Kreyl/SimpleJoy/ТЗ LiveTronic SimpleJoy v2.0 от 21.09.2017.pdf

# Техническое задание на разработку LiveTronic SimpleJoy

## Реализация управления устройствами детям 1-4 класса

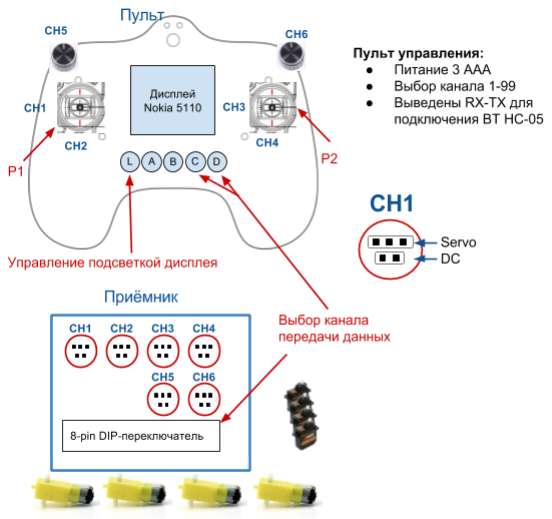
[picture p1: figure]

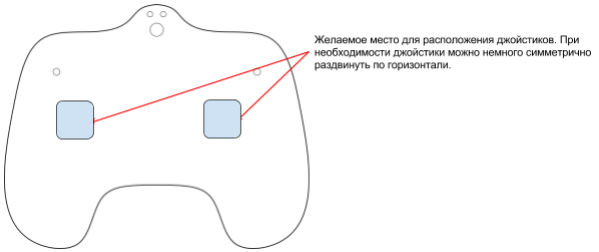
[picture p2: figure]

Пульт | управления
- Пульт | имеет | 6 | дифференциальных | каналов | для | управления: | CH1-CH6
CH1-CH4 работают в двух режимах: могут управлять DC-мотором либо сервомотором, сигнал подаётся одновременно, поэтому действовать будут синхронно. Сигнал от CH1-CH4 - градуальный.
- CH5-CH6 могут управлять сервомоторами либо двумя коллекторными моторами через полевой транзистор.
- Джойстики P1 И P2 также имеют кнопку на нажатие. Их необходимо завести на МК.
- Автокалибровка пульта: при включении пульт автоматически считает, что показания на реостатах являются нулевыми.
- Питание: 3ААA
- Радиус действия - не менее 50 метров уверенный приём сигнала (в идеале до 100)
- Если есть возможность, оставить место для последующей пайки модуля BT HC-05, если такой возможности нет, то оставить выводы RX и TX для подключения модуля без пайки.
- С МК необходимо управлять подсветкой дисплея
- Под дисплеем расположены 5 тактовых кнопок. Две из них в базовой прошивке используются для переключения каналов. Одна — подсветкой дисплея.
- По периметру платы требуются 4 крепёжные отверстия 3мм
- Разъём micro-USB для программирования MK и передачи команд с ПК
- Необходим главный переключатель/кнопка

## Приёмник

- Приёмник | имеет | 6 | дифференциальных | каналов: | CH1-CH6
CH1-CH4 работают в двух режимах: могут управлять DC-мотором либо сервомотором, сигнал подаётся одновременно, поэтому действовать будут синхронно. Сигнал от CH1-CH4 - градуальный.
- Питание
- Стабилизированные 5V
- 6V — 4AA батарейки
- 4.8V — 4AA аккумулятора

Разъём питания
http://www.zip-2002.ru/razyemy/razyemy_pitaniya_nizkovoltnye/55052/w-02_pitch_2.54mm/http://www.zip-2002.ru/razyemy/razyemy_pitaniya_nizkovoltnye/55070/w-02r_pitch_2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Предполагаемые компоненты:
Джойстик (https://ru.aliexpress.com/item/2pcs-3D-Controller-Joystick-Axis-Analog-Sensor-Modules-Thumbsticks-3D-Joystick-Handle-Rocker-For-Xbox-One/32720014359.html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)

Тактовые кнопки (http://www.zip-2002.ru/kommutatsiya/taktovye_knopki/83335/it-1187a_(4x4x4.3)/)

Референсы | на | дизайн
BT Джойстик (https://ru.aliexpress.com/item/ipega-pg-9055-Wireless-Bluetooth-Game-Controller-Joystick-For-iPhone-iPad-Android-Mobile-Phones-Tablet-PC/32791721858.html)

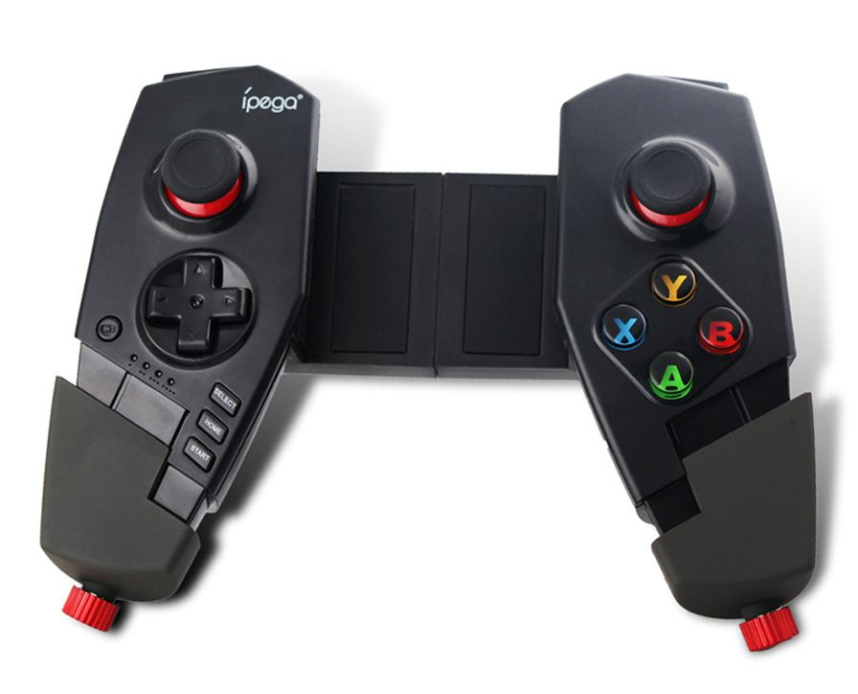
[picture p3: figure]
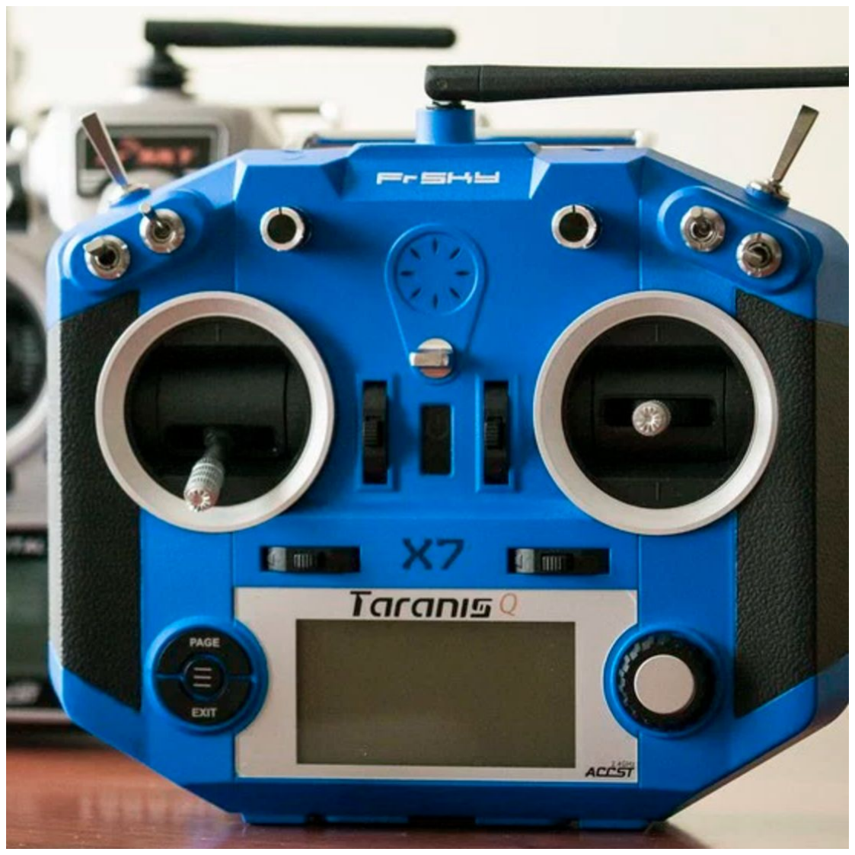
[picture p4: figure]
