Kreyl/SimpleJoy/SimpleJoyCommonBOM.xlsx

Reference | Value | Footprint | Quantity | SolderPoints | Price | Sum | PN | URL | Color
B1 | BAT | Installation:BATTERY_AAA_X3 | 1 | 2 | 30 | 30 |  | http://www.quartz1.com/price/model.php?akt=5470.11
BLN1 | BALUN868JOHANSON | Radio:BALUN_JOHANSON868 | 1 | 6 | 45 | 45 | 0896BM15A0001E | http://onelec.ru/products/0896bm15a0001e-52ab3408-7c12-4b8c-99ab-cc294cdc1e18
C1 C10 | 10n | Capacitors:CAP_0603 | 2 | 2 | 0.5 | 1
C11 C17 | 1u | Capacitors:CAP_0603 | 2 | 2 | 0.5 | 1
C14 C15 C3 C4 | 18pF | Capacitors:CAP_0603 | 4 | 2 | 0.5 | 2
C12 C13 C16 C18 C19 C21 C22 C24 C25 C5 C6 C7 C8 C9 | 0.1u | Capacitors:CAP_0603 | 14 | 2 | 0.5 | 7
C2 | 10u | Capacitors:CAP_0603 | 1 | 2 | 4 | 4
C20 | 2pF | Capacitors:CAP_0402 | 1 | 2 | 0.5 | 0.5
D1 D5 | L-C191LBCT | LEDs:LED_0603 | 2 | 2 | 2.4 | 4.8 | L-C191LBCT | http://onelec.ru/products/l-c191lbct | Blue
D2 D3 | PMEG2020 | Diodes:SOD323 | 2 | 2 | 5 | 10
D4 | L-C191KGCT | LEDs:LED_0603 | 1 | 2 | 2.2 | 2.2 | L-C191KGCT | http://onelec.ru/products/l-c191kgct | Green
DA1 | MCP1700 | SOT:SOT23-3 | 1 | 3 | 20 | 20 | MCP1700T-3302E/TT
DD1 | STM32F072RxTx | LQFP_TQFP:LQFP64 | 1 | 64 | 170 | 170 | stm32f072R8t6 | http://
DD2 | CC1101 | QFN_DFN:QFN20 | 1 | 21 | 140 | 140 |  | http://
J1 J2 | Joystick | BtnsSwitches:Joystick | 2 | 14 | 35 | 70 |  | https://ru.aliexpress.com/item/2pcs-3D-Controller-Joystick-Axis-Analog-Sensor-Modules-Thumbsticks-3D-Joystick-Handle-Rocker-For-Xbox-One/32720014359.html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
L1 L2 L3 | BLM15AG102 | Inductors:IND_0402 | 3 | 2 | 1 | 3 | BLM15AG102SN1
L4 | 1.2nH | Inductors:IND_0402 | 1 | 2 | 4 | 4
Q1 | 2N7002 | SOT:SOT23-3 | 1 | 3 | 1.6 | 1.6
R1 | 51R | Resistors:RES_0603 | 1 | 2 | 0.5 | 0.5
R12 R13 R2 R3 R5 | 1k | Resistors:RES_0603 | 5 | 2 | 0.5 | 2.5
R4 R9 | 56k | Resistors:RES_0603 | 2 | 2 | 0.5 | 1
R6 R7 | 10k | Resistors:VAR_PTV09A-4 | 2 | 5 | 11 | 22 |  | http://www.zip-2002.ru/rezistory/potentsiometry/69732/rs09-n-30_10k/
R10 R11 R8 | 100k | Resistors:RES_0603 | 3 | 2 | 0.5 | 1.5
SW2 | DIPx8 | BtnsSwitches:DIP_SMD_X8 | 1 | 16 | 35 | 35 | 1-1825058-9 | https://www.terraelectronica.ru/catalog_info.php?CODE=854801
SW3 | SWITCH | BtnsSwitches:SW_SS-12F23 | 1 | 5 | 5 | 5
SW1 SW4 SW5 SW6 SW7 SW8 | IT-1187A | BtnsSwitches:BTN_4x4_SMD | 6 | 4 | 4 | 24 |  | http://www.zip-2002.ru/kommutatsiya/taktovye_knopki/83335/it-1187a_(4x4x4.3)/
U1 | USBLC6 | SOT:SOT23-6 | 1 | 6 | 9 | 9 | USBLC6-2SC6 | https://www.terraelectronica.ru/catalog_info.php?CODE=244787
U2 | BT_HC05 | Modules:BT_HC0x | 1 | 34 |  | 0
XL1 | PBS-8 | Connectors:PLS-8 | 1 | 8 | 24 | 24 |  | http://www.quartz1.com/price/model.php?group=1136&ext=1932
XL2 | CONN_6 | Connectors:PLS-6 | 1 | 6 | 2 | 2
XL3 | USB_MINI_B | Connectors:USBmicro_MOLEX_WM17142 | 1 | 9 | 46 | 46 | 47491-0001
XL4 | CONN_1 | Connectors:PLS-1Rnd | 1 | 0 | 0 | 0
XTAL1 | 12MHz | Quartz:0503x4-4 | 1 | 4 | 15 | 15
XTAL2 | 27MHz | Quartz:03225C4 | 1 | 4 | 15 | 15
Печатная плата TX |  |  |  |  |  | 250
BLN1 | BALUN868JOHANSON | Radio:BALUN_JOHANSON868 | 1 | 6 | 45 | 0896BM15A0001E | http://onelec.ru/products/0896bm15a0001e-52ab3408-7c12-4b8c-99ab-cc294cdc1e18
C2 | 10u | Capacitors:CAP_0603 | 1 | 2 | 4
C26 C27 | 18pF | Capacitors:CAP_0603 | 2 | 2 | 0.5
C10 C11 C18 C19 C20 C21 C24 C25 C28 C3 C31 C33 C36 C37 C39 C4 C41 C42 C43 C5 C6 C7 | 0.1u | Capacitors:CAP_0603 | 22 | 2 | 0.5
C35 | 2.4pF | Capacitors:CAP_0402 | 1 | 2 | 0.5
C12 C13 C14 C15 C16 C17 C30 C38 | 100u 6V3 | Capacitors:CAP_1206 | 8 | 2 | 7 | CL31A107MQHNNNE
C1 C8 | 10n | Capacitors:CAP_0603 | 2 | 2 | 0.5
C32 C9 | 1u | Capacitors:CAP_0603 | 2 | 2 | 0.5
D1 | L-C191KGCT | LEDs:LED_0603 | 1 | 2 | 2.2 | L-C191KGCT | http://onelec.ru/products/l-c191kgct |  |  | Green
D2 | L-C191LBCT | LEDs:LED_0603 | 1 | 2 | 2.4 | L-C191LBCT | http://onelec.ru/products/l-c191lbct |  |  | Blue
D3 D4 D5 D6 | PMEG2020 | Diodes:SOD323 | 4 | 2 | 5.5 | PMEG2020EJ.115 | https://www.terraelectronica.ru/catalog_info.php?CODE=192057 | 2A 20V Vf=525mV
DA1 DA2 | DRV8835 | QFN_DFN:WSON12 | 2 | 13 | 95 | DRV8835DSSR | http://onelec.ru/products/drv8835dssr
DA3 DA7 | MCP1700 | SOT:SOT23-3A | 2 | 3 | 20 | MCP1700T-3302E/TT
DD1 | STM32F072RxTx | LQFP_TQFP:LQFP64 | 1 | 64 | 170 | stm32f072R8t6 | http://
DD2 | CC1101 | QFN_DFN:QFN20 | 1 | 21 | 140 |  | http://
L1 | BLM15AG102SN1 | Inductors:IND_0402 | 1 | 2 | 1
L2 | 1.2nH | Inductors:IND_0402 | 1 | 2 | 4
Q1 | IRF9358 | SO_DIL_TSSOP:SO8_150MIL | 1 | 8 | 29 |  | http://onelec.ru/products/irf9358pbf-dd012426-33d8-429e-9c6a-2b35b0a91da1
Q2 | 2N7002 | SOT:SOT23-3 | 1 | 3 | 1.6
Q3 Q4 | IRLML0030 | SOT:SOT23-3 | 2 | 3 | 7.5 | IRLML0030TRPBF | https://www.terraelectronica.ru/catalog.php?ID=349&search=irlml0030
R1 R3 R4 R5 | 1k | Resistors:RES_0603 | 4 | 2 | 0.5
R10 R6 R7 R9 | 100k | Resistors:RES_0603 | 4 | 2 | 0.5
R11 R12 R2 R8 | 56k | Resistors:RES_0603 | 4 | 2 | 0.5
SW1 | DIPx8 | BtnsSwitches:DIP_SMD_X8 | 1 | 16 | 27 |  | http://www.zip-2002.ru/kommutatsiya/dip_pereklyuchateli/71280/swd_4-8/
SW2 | IT-1187A | BtnsSwitches:BTN_4x4_SMD | 1 | 4 | 4 | IT-1187A
SW3 | 1P2T | BtnsSwitches:SW_SS-1P2T | 1 | 3 | 10
U1 | USBLC6 | SOT:SOT23-6 | 1 | 6 | 9 | USBLC6-2SC6 | https://www.terraelectronica.ru/catalog_info.php?CODE=244787
XL1 | CONN_6 | Connectors:PLS-6 | 1 | 6 | 1
XL10 XL11 XL12 XL13 XL15 XL16 XL19 XL20 XL21 XL9 | PLS3 | Connectors:PLS-3 | 10 | 3 | 1
XL14 XL17 XL4 XL5 XL6 XL7 XL8 | PLS2 | Connectors:PLS-2 | 7 | 2 | 0.5 |  |  |  | 2
XL18 | CONN_1 | Connectors:PLS-1Rnd | 1 | 0 | 0
XL2 | USB_MICRO | Connectors:USBmicro_MOLEX_1050170001 | 1 | 9 | 46 | 47491-0001
XL3 | CONN_2 | Connectors:W02_Pitch_2d54 | 1 | 2 | 2
XTAL1 | 27MHz | Quartz:03225C4 | 1 | 4 | 15
Печатная плата |  |  | 1 |  | 155 | 155
