Kreyl/SimpleJoy/Display.DXF

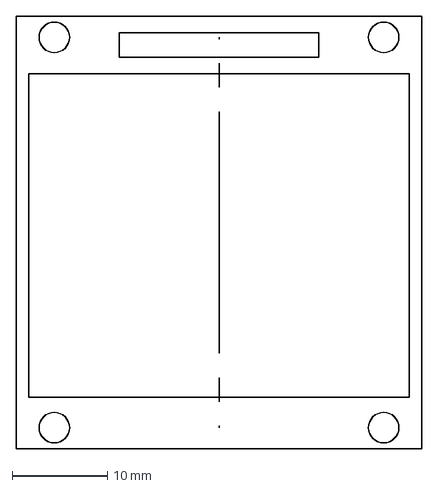
[picture p5: CAD file, 2022-06-04]
Display.DXF
42.6 x 45.4 mm
