Kreyl/SimpleJoy/Tx.dxf

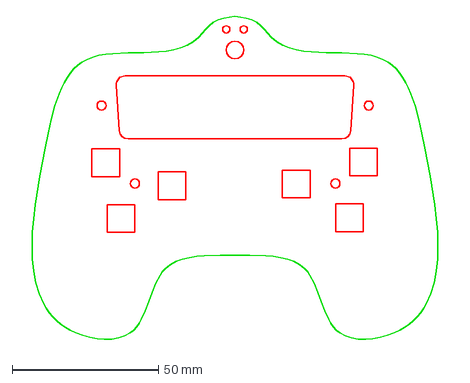
[picture p6: CAD file, 2022-06-04]
Tx.dxf
149.8 x 111.7 mm
