Kreyl/SimpleJoy/(list of files, cad)

Other CAD files:
TX.dwg
