Kreyl/SimpleJoy/SimpleJoyReceiverSch.pdf

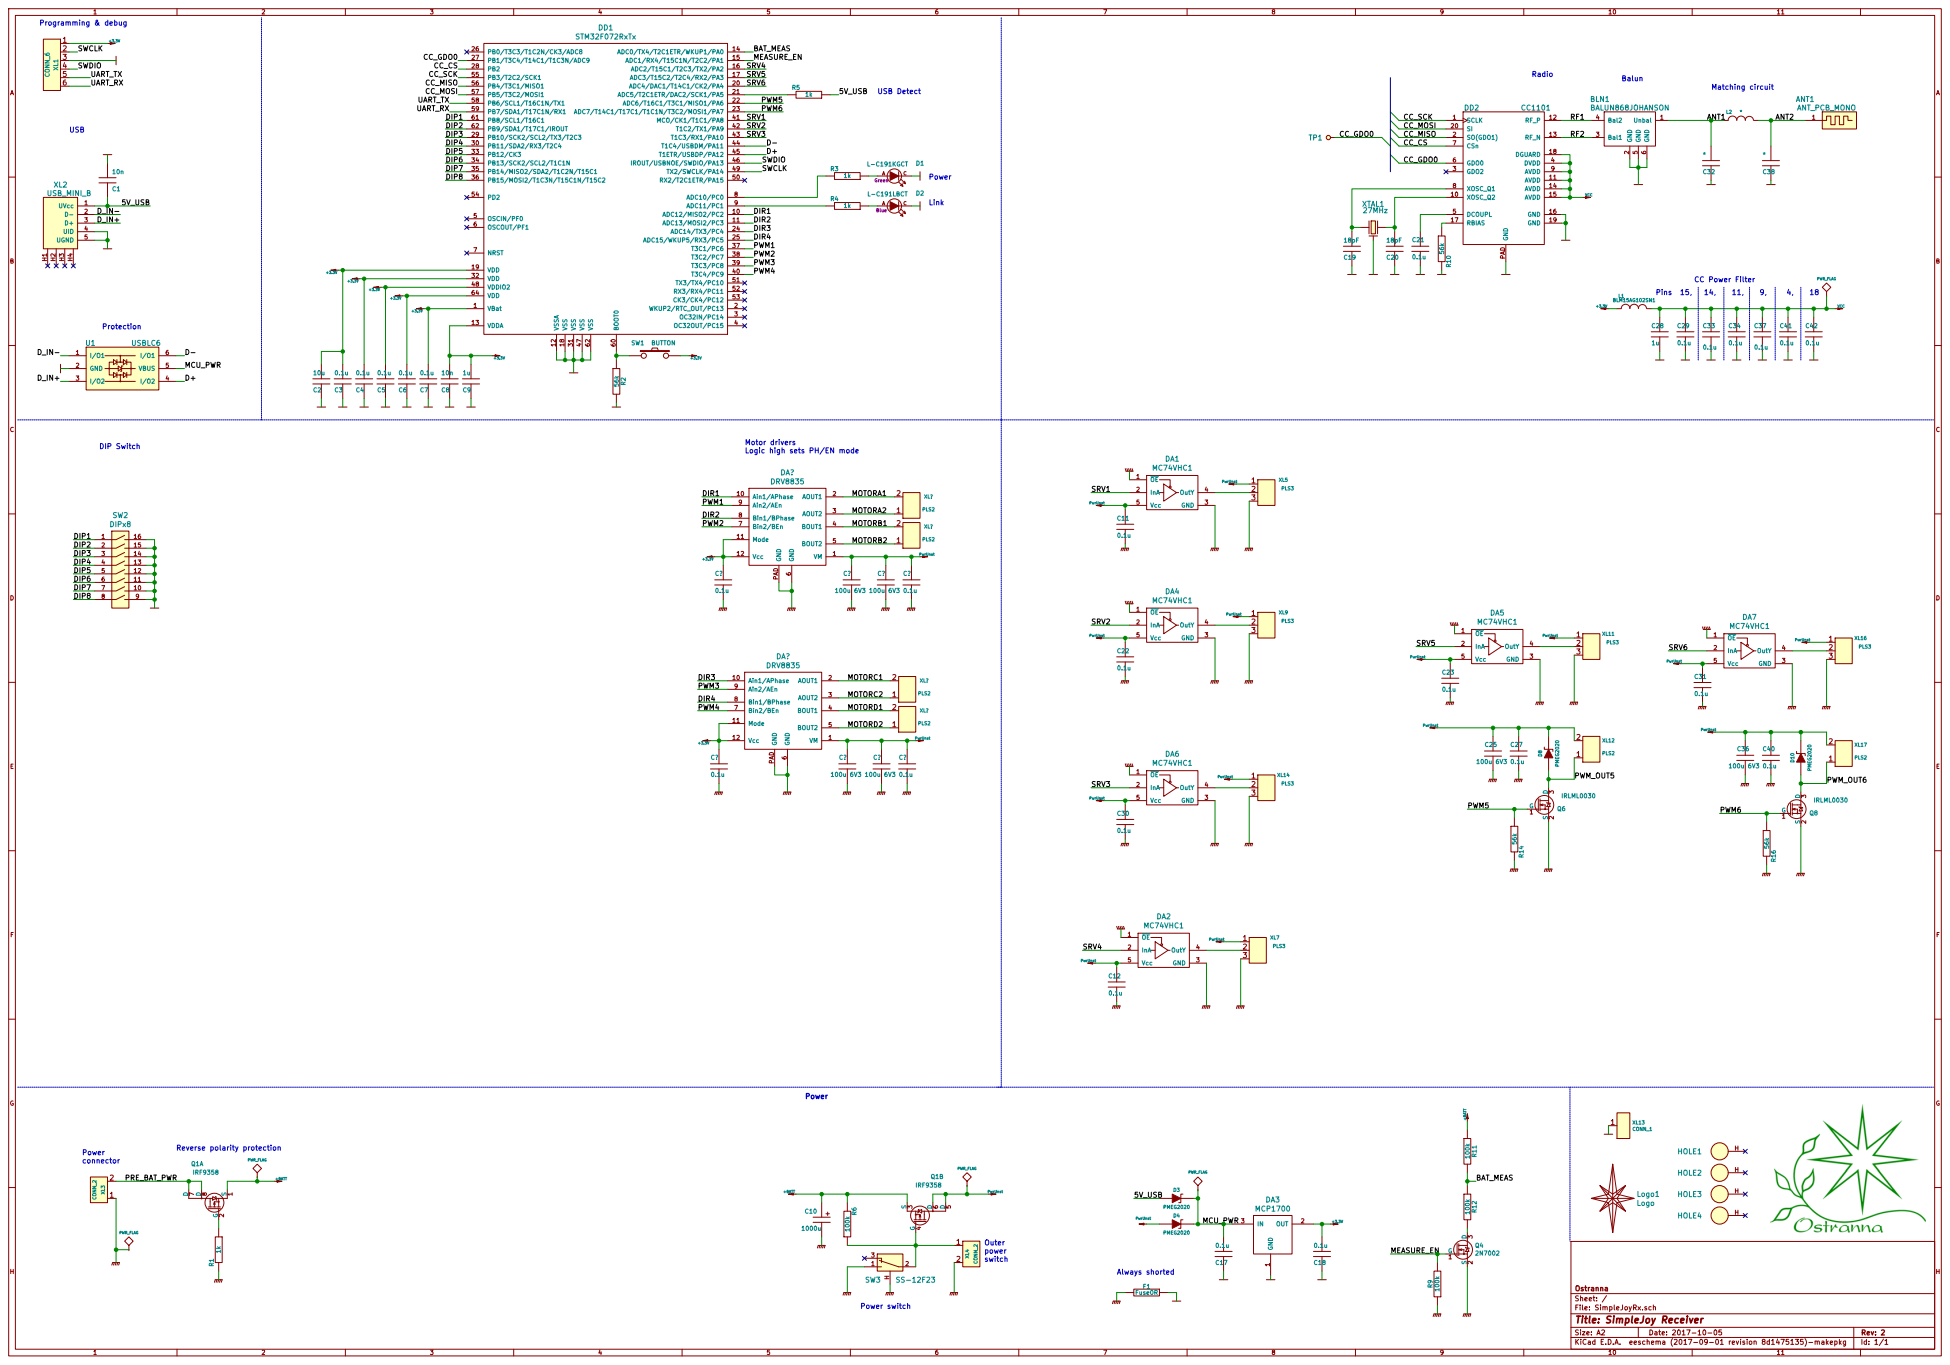
[picture p7: page 1]
