Kreyl/SimpleJoy/SimpleJoyTransmitterSch.pdf

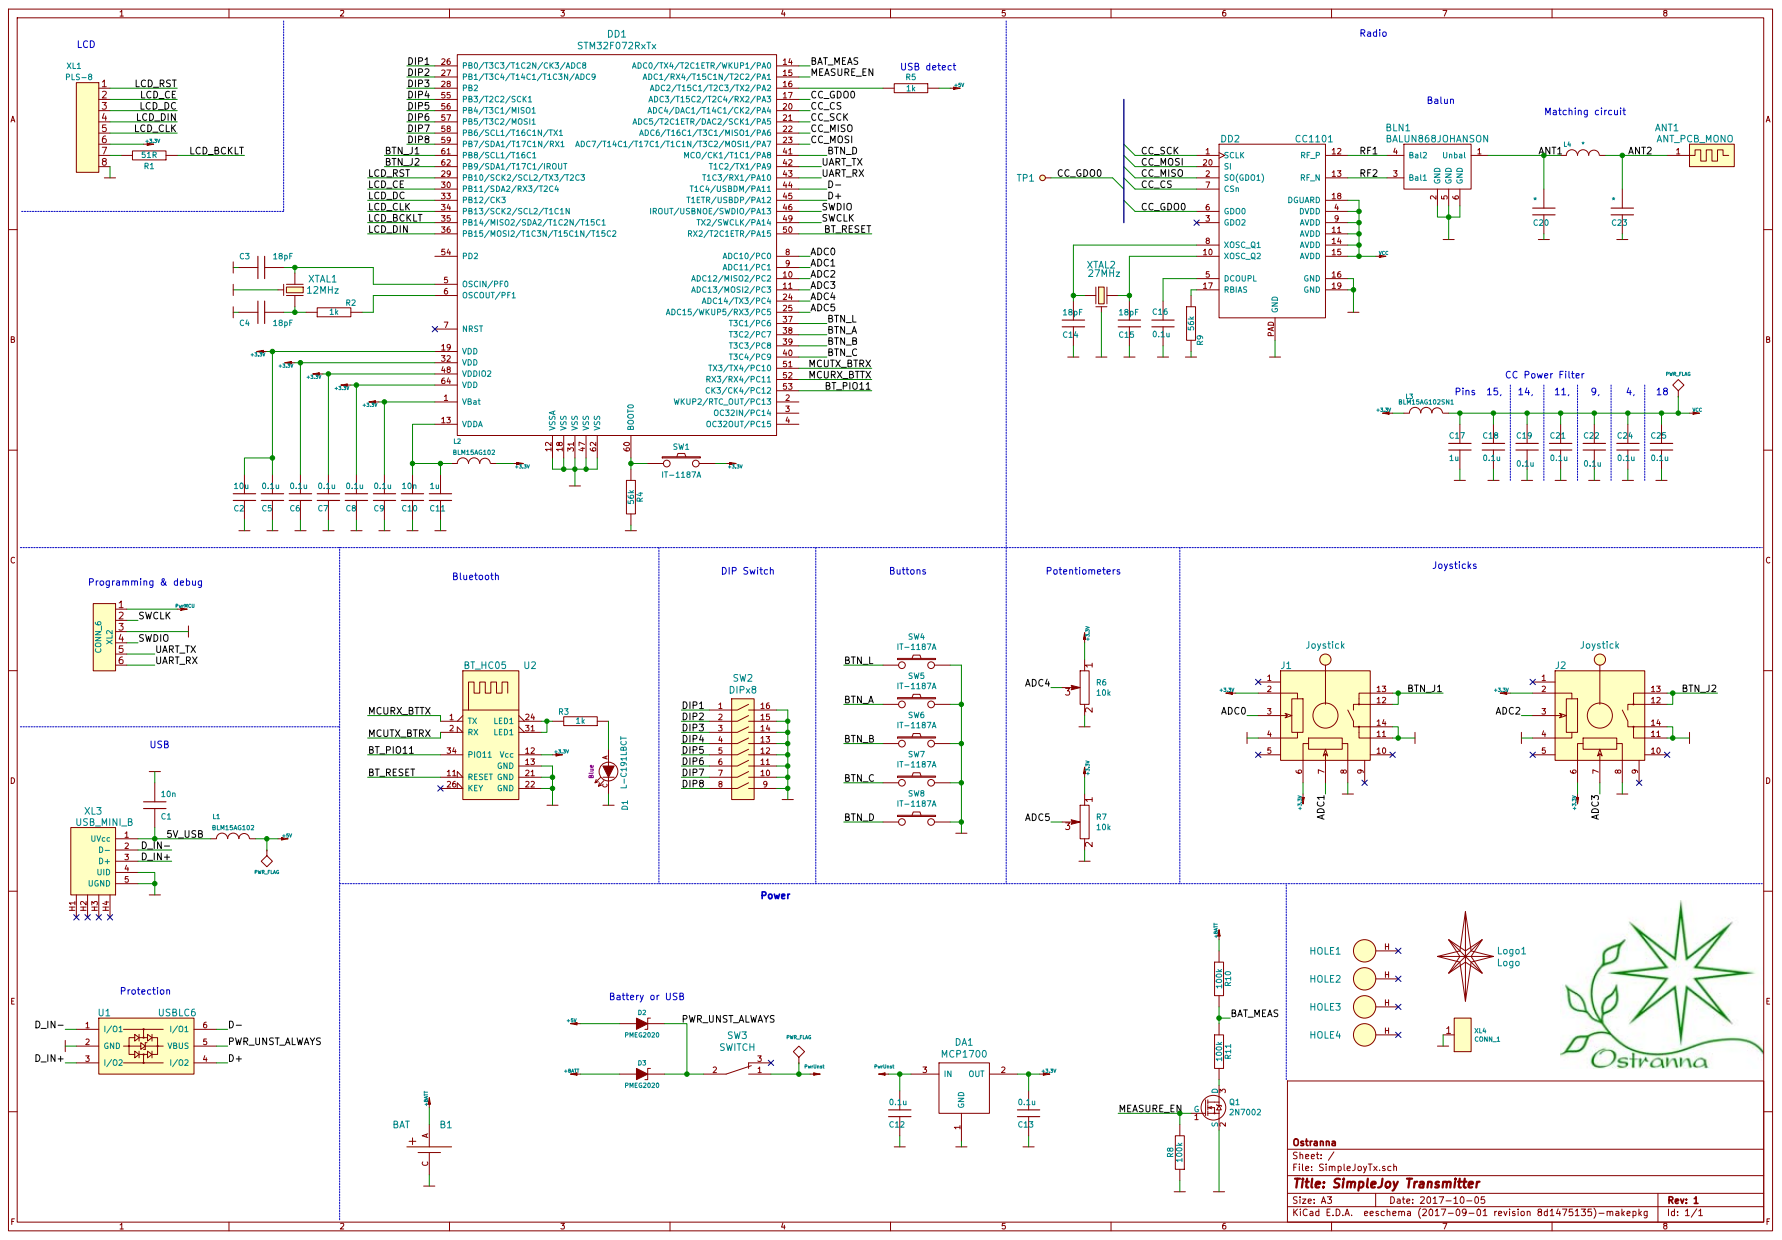
[picture p8: page 1]
