Kreyl/SimpleJoy/(list of files, drawings)

Other design files:
SimpleJoyRx_hw/SimpleJoyRx.dsn
SimpleJoyTx_hw/SimpleJoyTx.dsn
