Kreyl/SimpleJoy/SimpleJoyRx_hw/SimpleJoyRx.kicad_pcb

## KiCad design SimpleJoyRx_hw/SimpleJoyRx.kicad_pcb (2022-06-04)

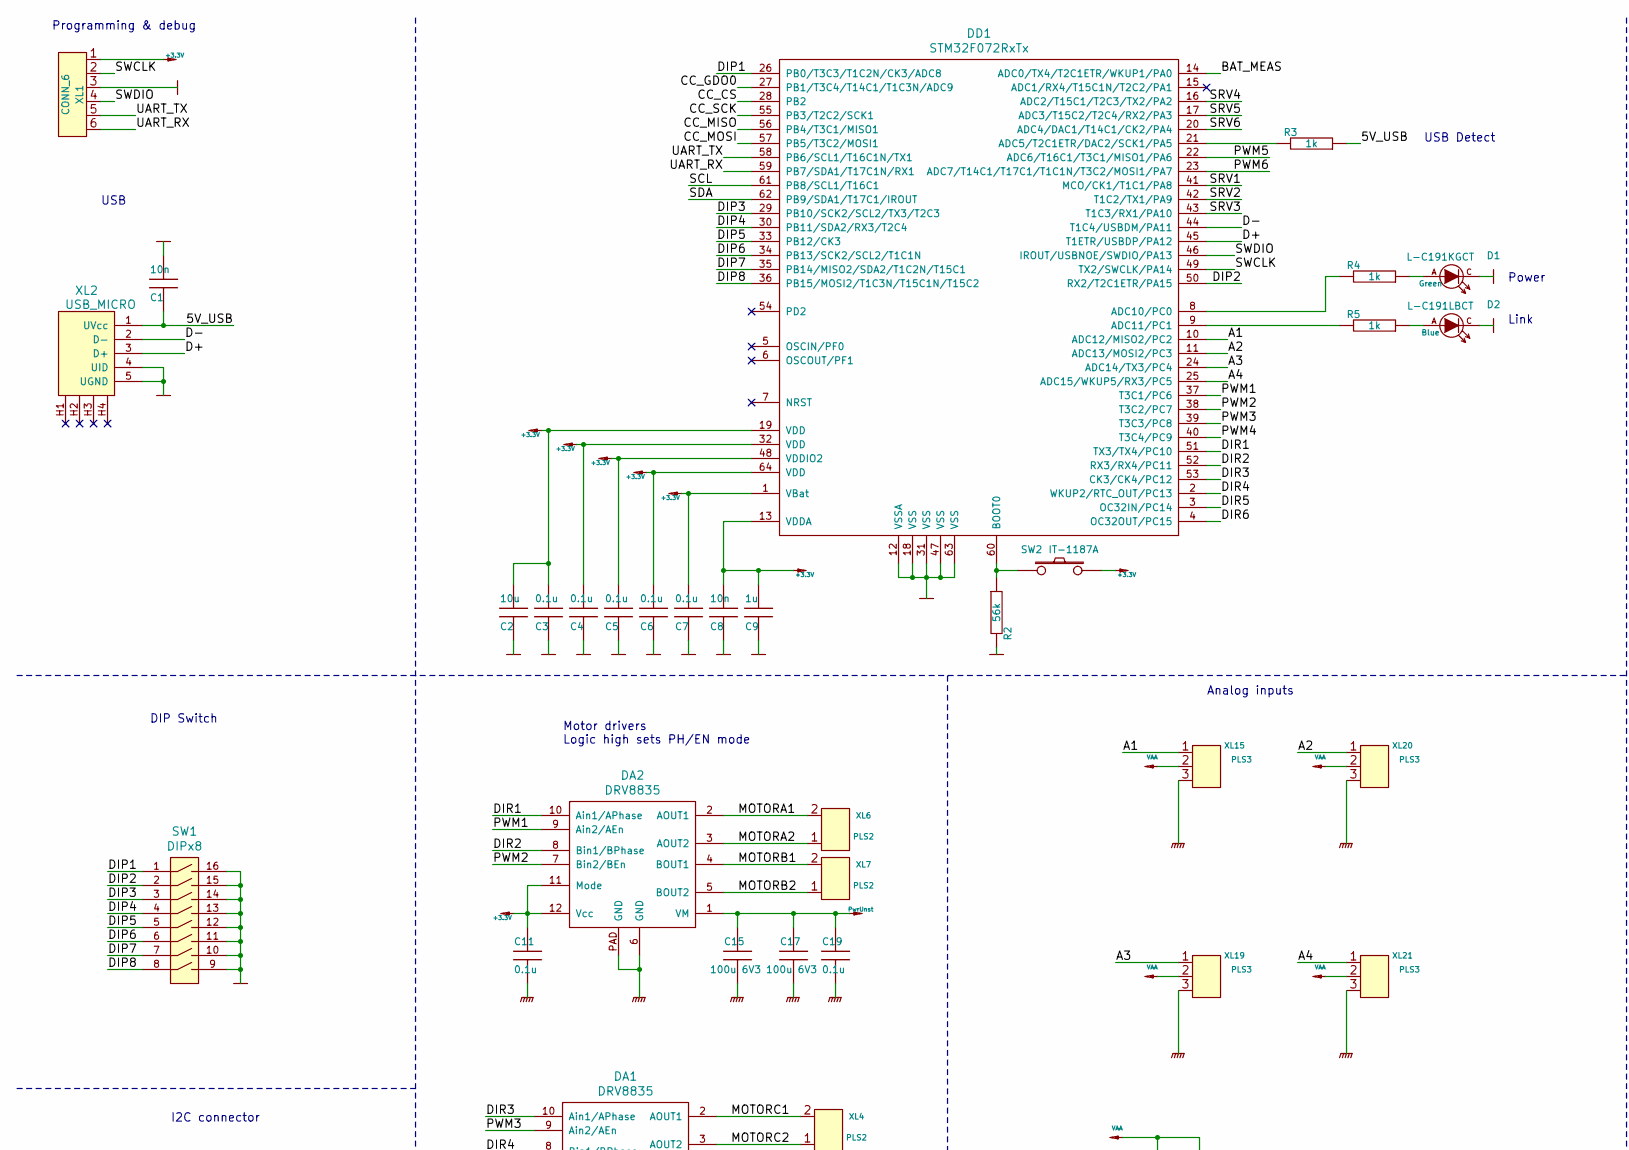
[picture p9: schematic SimpleJoyRx.sch, SimpleJoy Receiver, part in row 1, column 1]

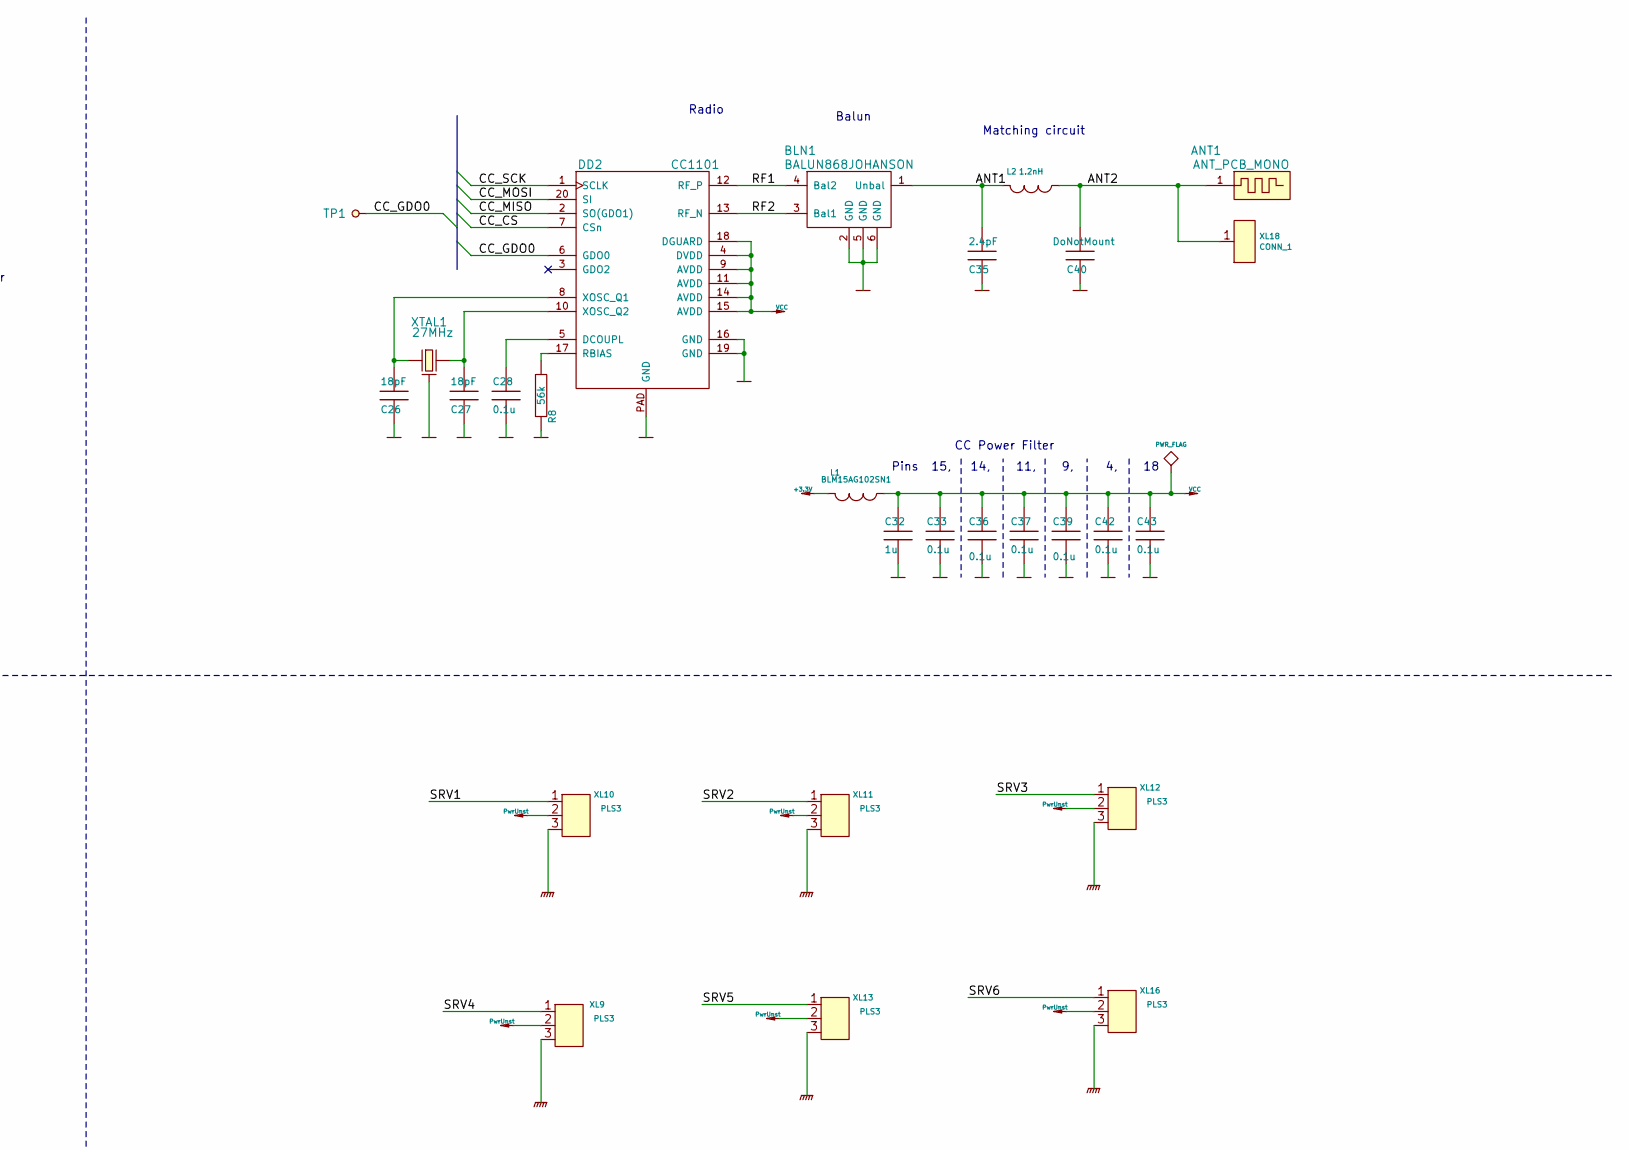
[picture p10: schematic SimpleJoyRx.sch, SimpleJoy Receiver, part in row 1, column 2]

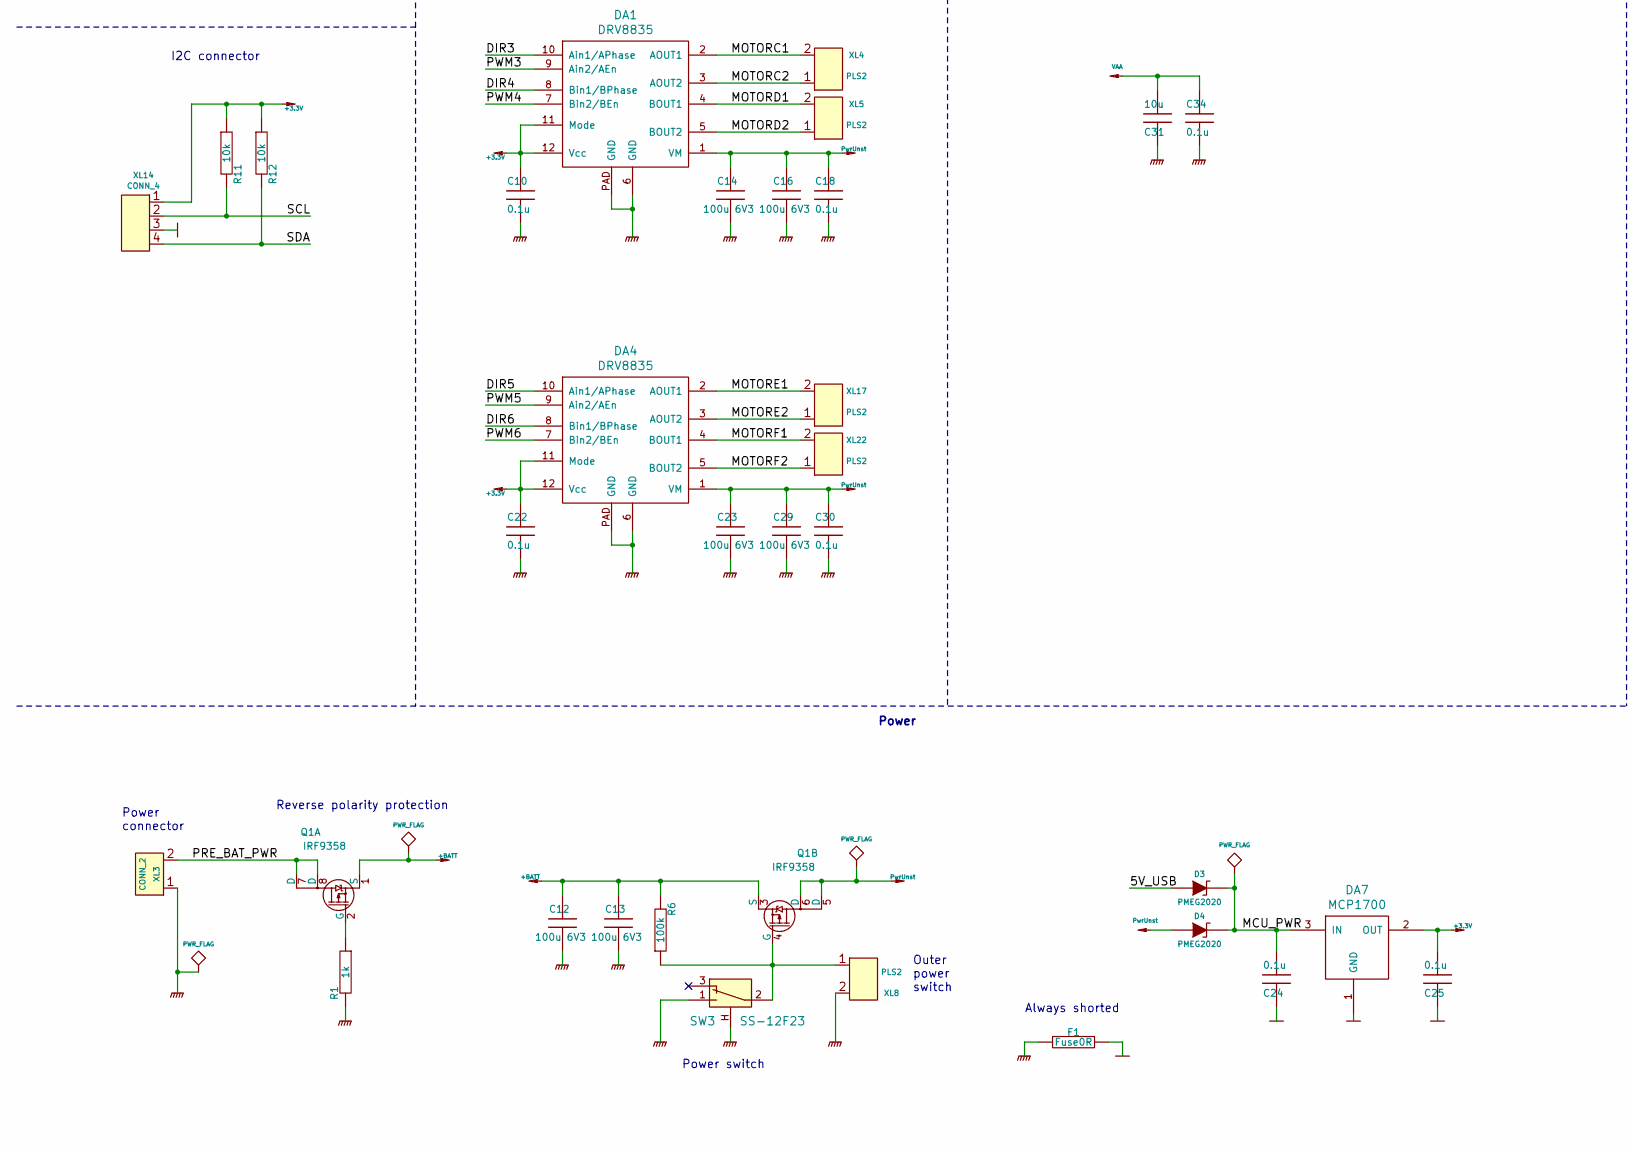
[picture p11: schematic SimpleJoyRx.sch, SimpleJoy Receiver, part in row 2, column 1]

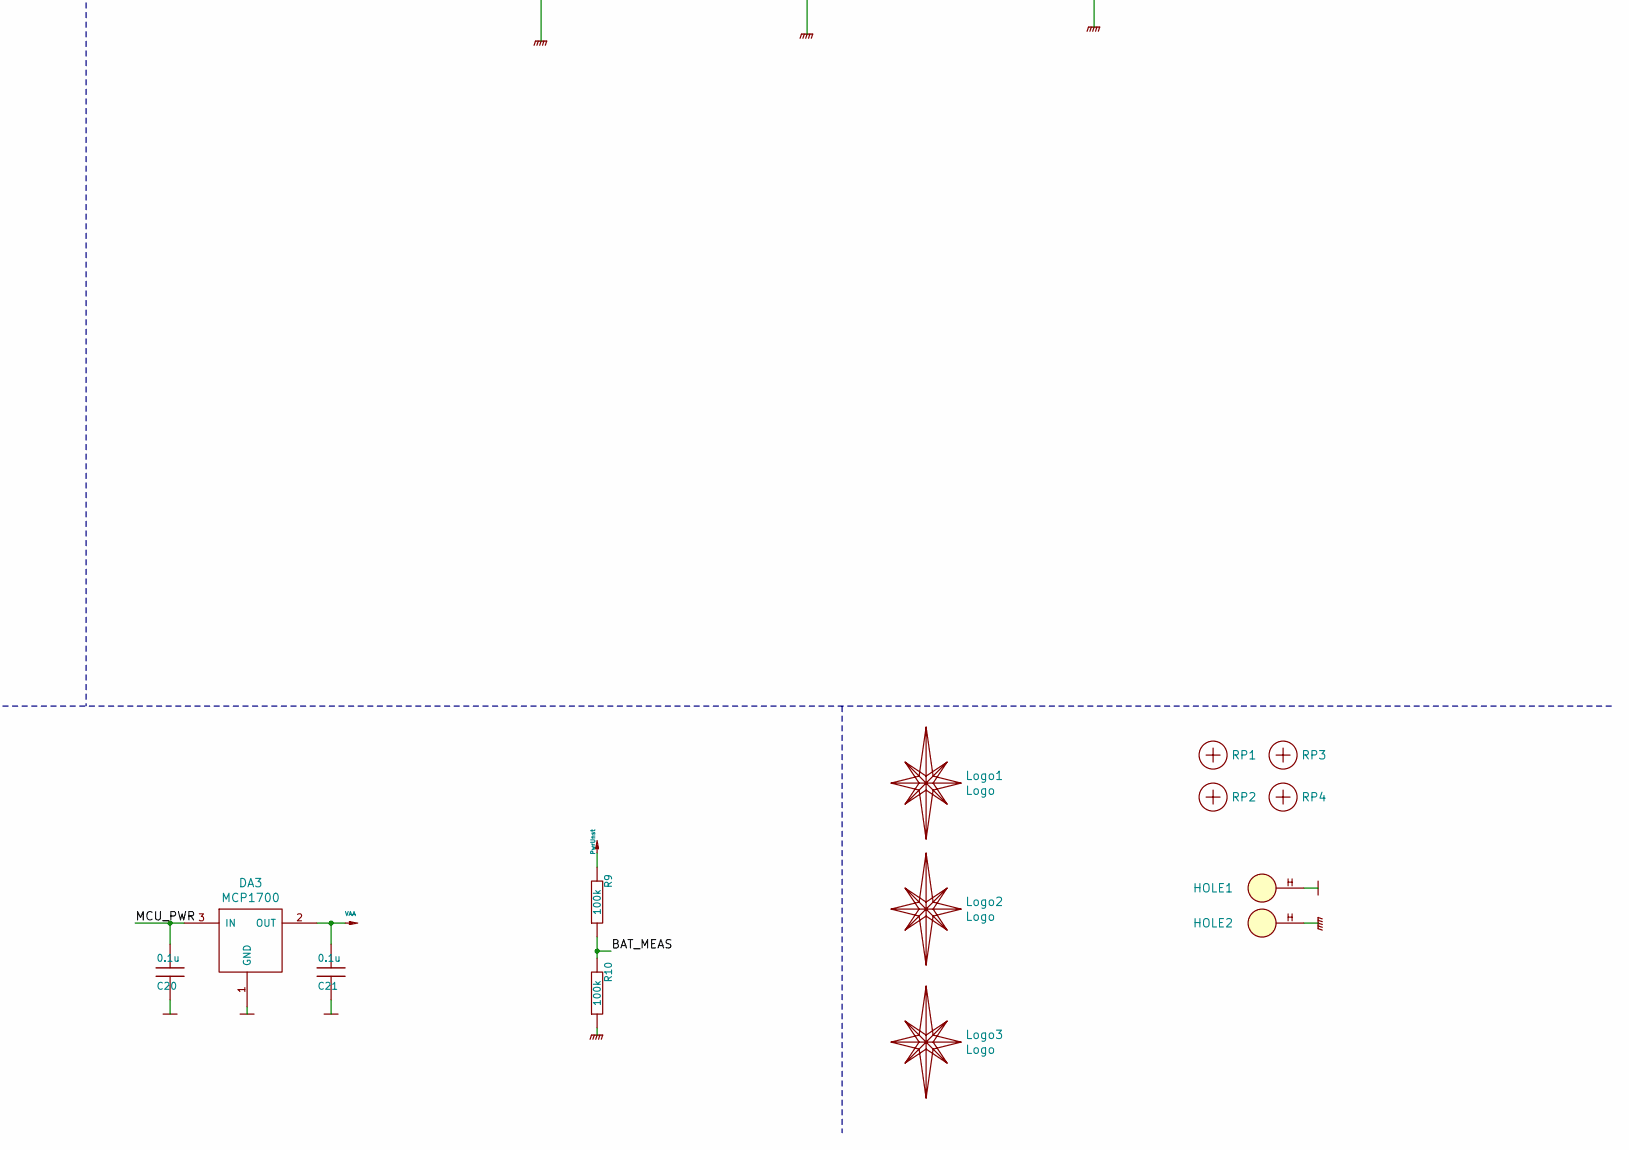
[picture p12: schematic SimpleJoyRx.sch, SimpleJoy Receiver, part in row 2, column 2]

Parts:
ANT1: ANT_PCB_MONO; ANT_868_24x30
BLN1: BALUN868JOHANSON; BALUN_JOHANSON868
C1, C8: 10n; CAP_0603
C2, C31: 10u; CAP_0603
C3, C4, C5, C6, C7, C10, C11, C18, C19, C20, C21, C22, C24, C25, C28, C30, C33, C34, C36, C37, C39, C42, C43: 0.1u; CAP_0603
C9, C32: 1u; CAP_0603
C12, C13, C14, C15, C16, C17, C23, C29: 100u 6V3; CAP_1206
C26, C27: 18pF; CAP_0603
C35: 2.4pF; CAP_0402
C40: DoNotMount; CAP_0402
D1: L-C191KGCT; LED_0603
D2: L-C191LBCT; LED_0603
D3, D4: PMEG2020; SOD323
DA1, DA2, DA4: DRV8835; WSON12
DA3, DA7: MCP1700; SOT23-3A
DD1: STM32F072RxTx; LQFP64
DD2: CC1101; QFN20
F1: Fuse0R; FuseShorted
HOLE1, HOLE2: HOLE_METALLED; Hole3d3_out5d5mm
L1: BLM15AG102SN1; IND_0402
L2: 1.2nH; IND_0402
Logo1: Logo; Ostranna_8x8
Logo2: Logo; Livetronic27x9
Logo3: Logo; Livetronic13x4
Q1: IRF9358; SO8_150MIL
R1, R3, R4, R5: 1k; RES_0603
R2, R8: 56k; RES_0603
R6, R9, R10: 100k; RES_0603
R11, R12: 10k; RES_0603
RP1, RP2, RP3, RP4: REFPOINT; REF_POINT_1MM
SW1: DIPx8; DIP_SMD_X8
SW2: IT-1187A; BTN_4x4_SMD
SW3: SS-12F23; SW_SS-12F23
TP1: TESTPOINT; TESTPOINT_1MM
XL1: CONN_6; PLS-6
XL2: USB_MICRO; USBmicro_MOLEX_1050170001
XL3: CONN_2; W02_Pitch_2d54
XL4, XL5, XL6, XL7, XL8, XL17, XL22: PLS2; PLS-2
XL9, XL10, XL11, XL12, XL13, XL15, XL16, XL19, XL20, XL21: PLS3; PLS-3
XL14: CONN_4; PLS-4
XL18: CONN_1; PLS-1Rnd
XTAL1: 27MHz; 03225C4

Connections:
+3.3V: C2.1, C3.1, C4.1, C5.1, C6.1, C7.1, C8.1, C9.1, C10.2, C11.2, C22.2, C25.1, DA1.11 (Mode), DA1.12 (Vcc), DA2.11 (Mode), DA2.12 (Vcc), DA4.11 (Mode), DA4.12 (Vcc), DA7.2 (OUT), DD1.1 (VBat), DD1.13 (VDDA), DD1.19 (VDD), DD1.32 (VDD), DD1.48 (VDDIO2), DD1.64 (VDD), L1.2, R11.1, R12.1, SW2.2, XL1.1, XL14.1
+BATT: C12.2, C13.2, Q1.1 (S), Q1.3 (S), R6.2
/5V_USB: C1.2, D3.A, R3.1, XL2.1 (UVcc)
/A1: DD1.10 (ADC12/MISO2/PC2), XL15.1
/A2: DD1.11 (ADC13/MOSI2/PC3), XL20.1
/A3: DD1.24 (ADC14/TX3/PC4), XL19.1
/A4: DD1.25 (ADC15/WKUP5/RX3/PC5), XL21.1
/ANT1: BLN1.1 (Unbal), C35.1, L2.2
/ANT2: ANT1.1, C40.1, L2.1, XL18.1
/BAT_MEAS: DD1.14 (ADC0/TX4/T2C1ETR/WKUP1/PA0), R9.1, R10.2
/CC_CS: DD1.28 (PB2), DD2.7 (CSn)
/CC_GDO0: DD1.27 (PB1/T3C4/T14C1/T1C3N/ADC9), DD2.6 (GDO0), TP1.1
/CC_MISO: DD1.56 (PB4/T3C1/MISO1), DD2.2 (SO(GDO1))
/CC_MOSI: DD1.57 (PB5/T3C2/MOSI1), DD2.20 (SI)
/CC_SCK: DD1.55 (PB3/T2C2/SCK1), DD2.1 (SCLK)
/D+: DD1.45 (T1ETR/USBDP/PA12), XL2.3 (D+)
/D-: DD1.44 (T1C4/USBDM/PA11), XL2.2 (D-)
/DIP1: DD1.26 (PB0/T3C3/T1C2N/CK3/ADC8), SW1.1
/DIP2: DD1.50 (RX2/T2C1ETR/PA15), SW1.2
/DIP3: DD1.29 (PB10/SCK2/SCL2/TX3/T2C3), SW1.3
/DIP4: DD1.30 (PB11/SDA2/RX3/T2C4), SW1.4
/DIP5: DD1.33 (PB12/CK3), SW1.5
/DIP6: DD1.34 (PB13/SCK2/SCL2/T1C1N), SW1.6
/DIP7: DD1.35 (PB14/MISO2/SDA2/T1C2N/T15C1), SW1.7
/DIP8: DD1.36 (PB15/MOSI2/T1C3N/T15C1N/T15C2), SW1.8
/DIR1: DA2.10 (Ain1/APhase), DD1.51 (TX3/TX4/PC10)
/DIR2: DA2.8 (Bin1/BPhase), DD1.52 (RX3/RX4/PC11)
/DIR3: DA1.10 (Ain1/APhase), DD1.53 (CK3/CK4/PC12)
/DIR4: DA1.8 (Bin1/BPhase), DD1.2 (WKUP2/RTC_OUT/PC13)
/DIR5: DA4.10 (Ain1/APhase), DD1.3 (OC32IN/PC14)
/DIR6: DA4.8 (Bin1/BPhase), DD1.4 (OC32OUT/PC15)
/MCU_PWR: C20.1, C24.1, D3.C, D4.C, DA3.3 (IN), DA7.3 (IN)
/MOTORA1: DA2.2 (AOUT1), XL6.2 (PM)
/MOTORA2: DA2.3 (AOUT2), XL6.1
/MOTORB1: DA2.4 (BOUT1), XL7.2 (PM)
/MOTORB2: DA2.5 (BOUT2), XL7.1
/MOTORC1: DA1.2 (AOUT1), XL4.2 (PM)
/MOTORC2: DA1.3 (AOUT2), XL4.1
/MOTORD1: DA1.4 (BOUT1), XL5.2 (PM)
/MOTORD2: DA1.5 (BOUT2), XL5.1
/MOTORE1: DA4.2 (AOUT1), XL17.2 (PM)
/MOTORE2: DA4.3 (AOUT2), XL17.1
/MOTORF1: DA4.4 (BOUT1), XL22.2 (PM)
/MOTORF2: DA4.5 (BOUT2), XL22.1
/PRE_BAT_PWR: Q1.7 (D), Q1.8 (D), XL3.2 (PM)
/PWM1: DA2.9 (Ain2/AEn), DD1.37 (T3C1/PC6)
/PWM2: DA2.7 (Bin2/BEn), DD1.38 (T3C2/PC7)
/PWM3: DA1.9 (Ain2/AEn), DD1.39 (T3C3/PC8)
/PWM4: DA1.7 (Bin2/BEn), DD1.40 (T3C4/PC9)
/PWM5: DA4.9 (Ain2/AEn), DD1.22 (ADC6/T16C1/T3C1/MISO1/PA6)
/PWM6: DA4.7 (Bin2/BEn), DD1.23 (ADC7/T14C1/T17C1/T1C1N/T3C2/MOSI1/PA7)
/RF1: BLN1.4 (Bal2), DD2.12 (RF_P)
/RF2: BLN1.3 (Bal1), DD2.13 (RF_N)
/SCL: DD1.61 (PB8/SCL1/T16C1), R11.2, XL14.2 (PM)
/SDA: DD1.62 (PB9/SDA1/T17C1/IROUT), R12.2, XL14.4
/SRV1: DD1.41 (MCO/CK1/T1C1/PA8), XL10.1
/SRV2: DD1.42 (T1C2/TX1/PA9), XL11.1
/SRV3: DD1.43 (T1C3/RX1/PA10), XL12.1
/SRV4: DD1.16 (ADC2/T15C1/T2C3/TX2/PA2), XL9.1
/SRV5: DD1.17 (ADC3/T15C2/T2C4/RX2/PA3), XL13.1
/SRV6: DD1.20 (ADC4/DAC1/T14C1/CK2/PA4), XL16.1
/SWCLK: DD1.49 (TX2/SWCLK/PA14), XL1.2
/SWDIO: DD1.46 (IROUT/USBNOE/SWDIO/PA13), XL1.4
/UART_RX: DD1.59 (PB7/SDA1/T17C1N/RX1), XL1.6
/UART_TX: DD1.58 (PB6/SCL1/T16C1N/TX1), XL1.5
GND: BLN1.2 (GND), BLN1.5 (GND), BLN1.6 (GND), C1.1, C2.2, C3.2, C4.2, C5.2, C6.2, C7.2, C8.2, C9.2, C20.2, C21.2, C24.2, C25.2, C26.2, C27.2, C28.1, C32.1, C33.2, C35.2, C36.2, C37.2, C39.2, C40.2, C42.2, C43.2, D1.C, D2.C, DA3.1 (GND), DA7.1 (GND), DD1.12 (VSSA), DD1.18 (VSS), DD1.31 (VSS), DD1.47 (VSS), DD1.63 (VSS), DD2.16 (GND), DD2.19 (GND), DD2.PAD (GND), F1.1, HOLE1.H, R2.2, R8.2, SW1.9, SW1.10, SW1.11, SW1.12, SW1.13, SW1.14, SW1.15, SW1.16, XL1.3, XL2.4 (UID), XL2.5 (UGND), XL14.3, XTAL1.H
GNDPWR: C10.1, C11.1, C12.1, C13.1, C14.1, C15.1, C16.1, C17.1, C18.1, C19.1, C22.1, C23.1, C29.1, C30.1, C31.2, C34.1, DA1.6 (GND), DA1.PAD (GND), DA2.6 (GND), DA2.PAD (GND), DA4.6 (GND), DA4.PAD (GND), F1.2, HOLE2.H, R1.2, R10.1, SW3.1, SW3.H, XL3.1, XL8.2 (PM), XL9.3, XL10.3, XL11.3, XL12.3, XL13.3, XL15.3, XL16.3, XL19.3, XL20.3, XL21.3
unnamed: C26.1, DD2.8 (XOSC_Q1), XTAL1.1
unnamed: C27.1, DD2.10 (XOSC_Q2), XTAL1.2
unnamed: C28.2, DD2.5 (DCOUPL)
unnamed: D1.A, R4.1
unnamed: D2.A, R5.1
unnamed: DD1.8 (ADC10/PC0), R4.2
unnamed: DD1.9 (ADC11/PC1), R5.2
unnamed: DD1.21 (ADC5/T2C1ETR/DAC2/SCK1/PA5), R3.2
unnamed: DD1.60 (BOOT0), R2.1, SW2.1
unnamed: DD2.17 (RBIAS), R8.1
unnamed: Q1.2 (G), R1.1
unnamed: Q1.4 (G), R6.1, SW3.2, XL8.1
PwrUnst: C14.2, C15.2, C16.2, C17.2, C18.2, C19.2, C23.2, C29.2, C30.2, D4.A, DA1.1 (VM), DA2.1 (VM), DA4.1 (VM), Q1.5 (D), Q1.6 (D), R9.2, XL9.2 (PM), XL10.2 (PM), XL11.2 (PM), XL12.2 (PM), XL13.2 (PM), XL16.2 (PM)
VAA: C21.1, C31.1, C34.2, DA3.2 (OUT), XL15.2 (PM), XL19.2 (PM), XL20.2 (PM), XL21.2 (PM)
VCC: C32.2, C33.1, C36.1, C37.1, C39.1, C42.1, C43.1, DD2.4 (DVDD), DD2.9 (AVDD), DD2.11 (AVDD), DD2.14 (AVDD), DD2.15 (AVDD), DD2.18 (DGUARD), L1.1

Notes on the sheet:
Programming & debug
USB
Power connector
DIP Switch
I2C connector
Reverse polarity protection
Motor drivers Logic high sets PH/EN mode
Power switch
Power
Outer power switch
Always shorted
Analog inputs
USB Detect
Link
Radio
Balun
Pins 15, 14, 11, 9, 4, 18
CC Power Filter
Matching circuit

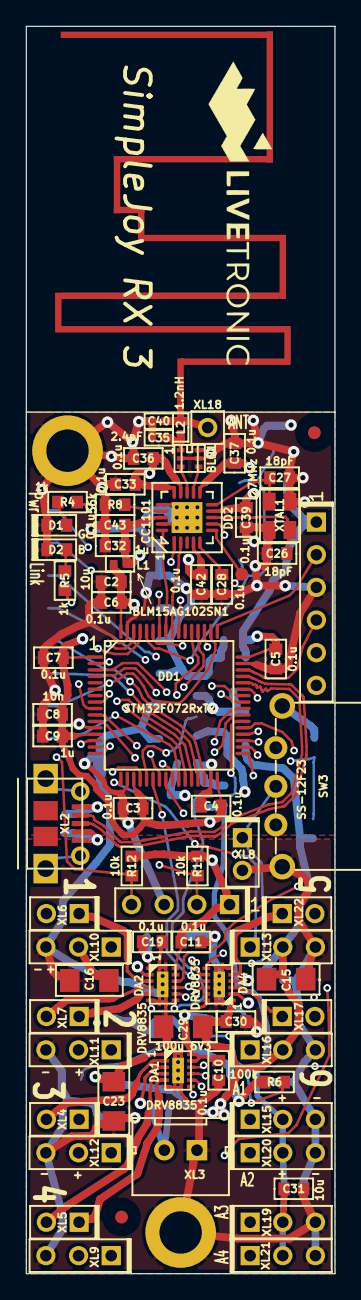
[picture p13: board SimpleJoyRx.kicad_pcb from above]

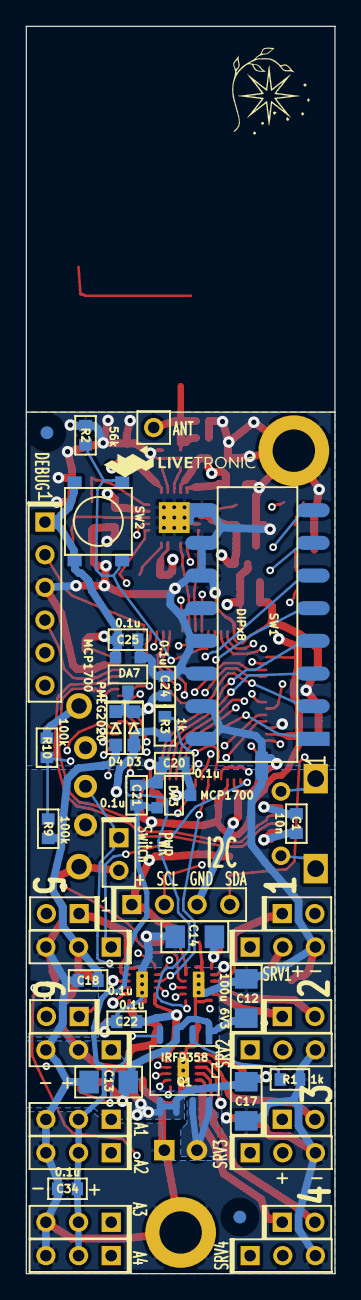
[picture p14: board SimpleJoyRx.kicad_pcb from below]

Board: 4 copper layers, 24.0 x 97.0 mm, 105 parts (29 on the bottom side), 82 nets.
