Kreyl/SimpleJoy/SimpleJoyTx_hw/SimpleJoyTx.kicad_pcb

## KiCad design SimpleJoyTx_hw/SimpleJoyTx.kicad_pcb (2022-06-04)

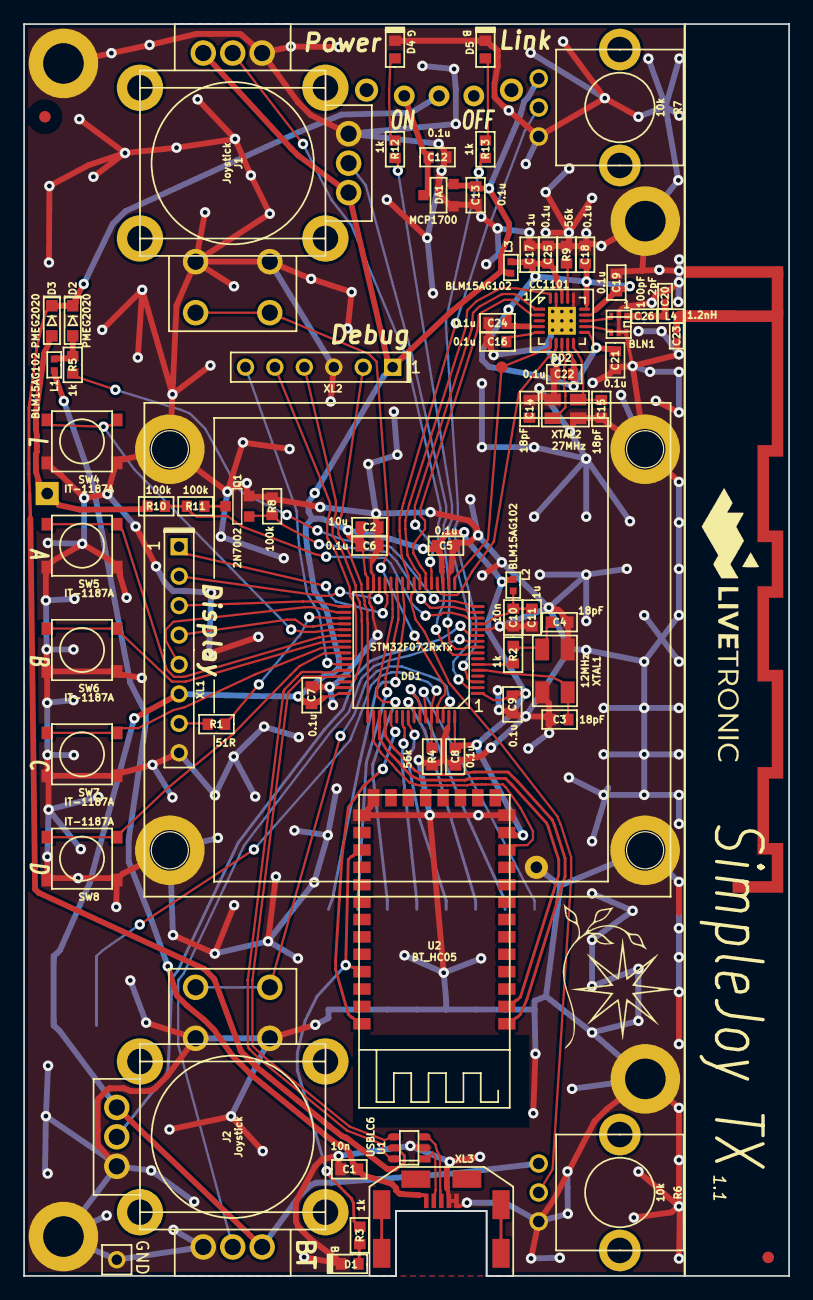
[picture p15: board SimpleJoyTx.kicad_pcb from above]

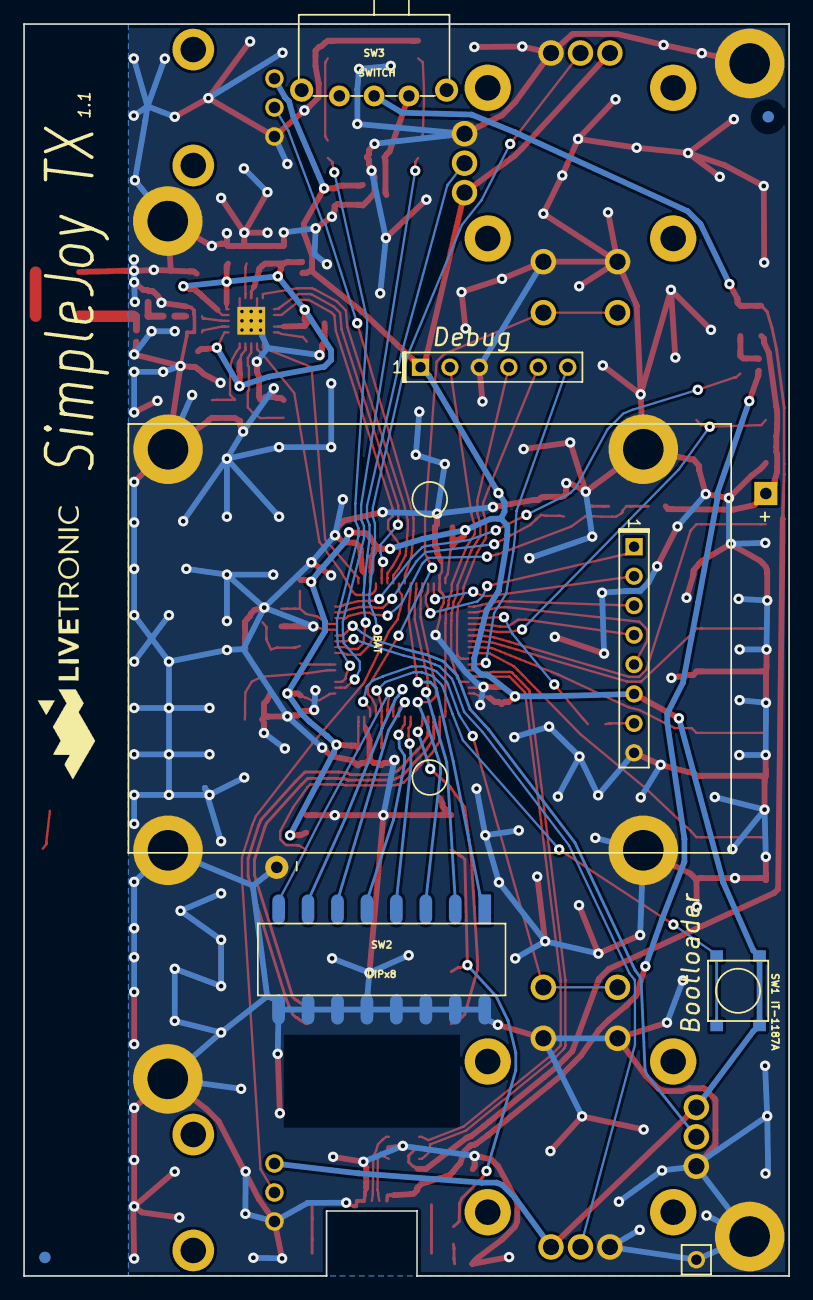
[picture p16: board SimpleJoyTx.kicad_pcb from below]

Board: 2 copper layers, 66.0 x 108.0 mm, 89 parts (7 on the bottom side), 77 nets.

Parts:
ANT1: ANT_PCB_MONO_2PIN; ANT_868_IFA_SIMPLEJOY
B1: BAT; BATTERY_AAA_X3
BLN1: BALUN868JOHANSON; BALUN_JOHANSON868
C1, C10: 10n; CAP_0603
C2: 10u; CAP_0603
C3, C4, C14, C15: 18pF; CAP_0603
C5, C6, C7, C8, C9, C12, C13, C16, C18, C19, C21, C22, C24, C25: 0.1u; CAP_0603
C11, C17: 1u; CAP_0603
C20: 2pF; CAP_0402
C23: DoNotMount; CAP_0402
C26: 100pF; CAP_0402
D1, D5: L-C191LBCT; LED_0603
D2, D3: PMEG2020; SOD323
D4: L-C191KGCT; LED_0603
DA1: MCP1700; SOT23-3A
DD1: STM32F072RxTx; LQFP64
DD2: CC1101; QFN20
HOLE1, HOLE2, HOLE3, HOLE4, HOLE5, HOLE6, HOLE7, HOLE8: HOLE_METALLED; Hole3_5_out6mm
J1, J2: Joystick
L1, L2, L3: BLM15AG102; IND_0402
L4: 1.2nH; IND_0402
Logo1: Logo; Ostranna_12d7_10d1
Logo2, Logo3: Logo; Livetronic27x9
Q1: 2N7002; SOT23-3
R1: 51R; RES_0603
R2, R3, R5, R12, R13: 1k; RES_0603
R4, R9: 56k; RES_0603
R6, R7: 10k; VAR_PTV09A-4
R8, R10, R11: 100k; RES_0603
RP1, RP2, RP3, RP4: REFPOINT; REF_POINT_1MM
SW1, SW4, SW5, SW6, SW7, SW8: IT-1187A; BTN_4x4_SMD
SW2: DIPx8; DIP_SMD_X8
SW3: SWITCH; SW_SS-12F23
TP1: TESTPOINT; TESTPOINT_1MM
U1: USBLC6; SOT23-6
U2: BT_HC05; BT_HC0x
XL1: PBS-8; PLS-8
XL2: CONN_6; PLS-6
XL3: USB_MINI_B; USBmicro_MOLEX_WM17142
XL4: CONN_1; PLS-1Rnd
XTAL1: 12MHz; 0503x4-4
XTAL2: 27MHz; 03225C4

Connections:
+3.3V: C2.1, C5.1, C6.1, C7.1, C8.1, C9.1, C13.1, DA1.2, DD1.1, DD1.19, DD1.32, DD1.48, DD1.64, J1.4, J1.10, J2.4, J2.10, L2.1, L3.2, R6.1, R7.1, SW1.2, U2.12, XL1.6, XL2.1
+5V: D2.A, L1.1, R5.1
+BATT: B1.A, D3.A, R10.2
/5V_USB: C1.2, L1.2, XL3.1
/ADC0: DD1.8, J1.9
/ADC1: DD1.9, J1.5
/ADC2: DD1.10, J2.9
/ADC3: DD1.11, J2.5
/ADC4: DD1.24, R6.3
/ADC5: DD1.25, R7.3
/ANT1: C20.1, C26.1, L4.2
/ANT2: ANT1.1, C23.1, L4.1
/BAT_MEAS: DD1.14, R10.1, R11.2
/BTN_A: DD1.38, SW5.1
/BTN_B: DD1.39, SW6.1
/BTN_C: DD1.40, SW7.1
/BTN_D: DD1.41, SW8.1
/BTN_J1: DD1.61, J1.1, J1.14
/BTN_J2: DD1.62, J2.1, J2.14
/BTN_L: DD1.37, SW4.1
/BT_PIO11: DD1.53, U2.34
/BT_RESET: DD1.50, U2.11
/CC_CS: DD1.20, DD2.7
/CC_GDO0: DD1.17, DD2.6, TP1.1
/CC_MISO: DD1.22, DD2.2
/CC_MOSI: DD1.23, DD2.20
/CC_SCK: DD1.21, DD2.1
/D+: DD1.45, U1.4
/D-: DD1.44, U1.6
/DIP1: DD1.26, SW2.1
/DIP2: DD1.27, SW2.2
/DIP3: DD1.28, SW2.3
/DIP4: DD1.55, SW2.4
/DIP5: DD1.56, SW2.5
/DIP6: DD1.57, SW2.6
/DIP7: DD1.58, SW2.7
/DIP8: DD1.59, SW2.8
/D_IN+: U1.3, XL3.3
/D_IN-: U1.1, XL3.2
/LCD_BCKLT: DD1.35, R1.1
/LCD_CE: DD1.30, XL1.2
/LCD_CLK: DD1.34, XL1.5
/LCD_DC: DD1.33, XL1.3
/LCD_DIN: DD1.36, XL1.4
/LCD_RST: DD1.29, XL1.1
/MCURX_BTTX: DD1.52, U2.1
/MCUTX_BTRX: DD1.51, U2.2
/MEASURE_EN: DD1.15, Q1.1, R8.2
/PWR_UNST_ALWAYS: D2.C, D3.C, SW3.2, U1.5
/RF1: BLN1.4, DD2.12
/RF2: BLN1.3, DD2.13
/SWCLK: DD1.49, XL2.2
/SWDIO: DD1.46, XL2.4
/UART_RX: DD1.43, XL2.6
/UART_TX: DD1.42, XL2.5
GND: ANT1.2, B1.C, BLN1.2, BLN1.5, BLN1.6, C1.1, C2.2, C3.2, C4.2, C5.2, C6.2, C7.2, C8.2, C9.2, C10.2, C11.2, C12.2, C13.2, C14.2, C15.2, C16.1, C17.2, C18.2, C19.2, C20.2, C21.2, C22.2, C23.2, C24.2, C25.2, D1.C, D4.C, D5.C, DA1.1, DD1.12, DD1.18, DD1.31, DD1.47, DD1.63, DD2.16, DD2.19, DD2.PAD, HOLE1.H, HOLE2.H, HOLE3.H, HOLE4.H, HOLE5.H, HOLE6.H, HOLE7.H, HOLE8.H, J1.2, J1.6, J1.8, J1.13, J2.2, J2.6, J2.8, J2.13, Q1.2, R4.2, R6.2, R7.2, R8.1, R9.2, SW2.9, SW2.10, SW2.11, SW2.12, SW2.13, SW2.14, SW2.15, SW2.16, SW4.2, SW5.2, SW6.2, SW7.2, SW8.2, U1.2, U2.13, U2.21, U2.22, XL1.8, XL2.3, XL3.4, XL3.5, XL4.1, XTAL1.H, XTAL2.H
unnamed: BLN1.1, C26.2
unnamed: C3.1, DD1.5, XTAL1.1
unnamed: C4.1, R2.1, XTAL1.2
unnamed: C10.1, C11.1, DD1.13, L2.2
unnamed: C14.1, DD2.8, XTAL2.1
unnamed: C15.1, DD2.10, XTAL2.2
unnamed: C16.2, DD2.5
unnamed: D1.A, R3.1
unnamed: D4.A, R12.1
unnamed: D5.A, R13.1
unnamed: DD1.2, R12.2
unnamed: DD1.3, R13.2
unnamed: DD1.6, R2.2
unnamed: DD1.16, R5.2
unnamed: DD1.60, R4.1, SW1.1
unnamed: DD2.17, R9.1
unnamed: Q1.3, R11.1
unnamed: R1.2, XL1.7
unnamed: R3.2, U2.24, U2.31
PwrUnst: C12.1, DA1.3, SW3.1
VCC: C17.1, C18.1, C19.1, C21.1, C22.1, C24.1, C25.1, DD2.4, DD2.9, DD2.11, DD2.14, DD2.15, DD2.18, L3.1
