Kreyl/SimpleJoy/(commit log)

2017-10-03 TX sch started
    [SimpleJoyTx.kicad_pcb, SimpleJoyTx.sch]
2017-10-04 Proceeding with RX
    [SimpleJoyRx.sch, SimpleJoyTx.kicad_pcb, SimpleJoyTx.sch]
2017-10-05 + TX sch RC
    [SimpleJoyRx.sch, SimpleJoyTx.sch]
2017-10-05 + RX sch
    [SimpleJoyRx.sch]
2017-10-05 * DRV8835 for 4 channels
    [SimpleJoyRx.sch]
2017-10-07 RX PCB 2x5
    [SimpleJoyRx.kicad_pcb, SimpleJoyRx.sch]
2017-10-07 RX layout done
    [SimpleJoyRx.kicad_pcb, SimpleJoyRx.sch]
2017-10-09 Rx tracing done
    [SimpleJoyRx.dsn, SimpleJoyRx.kicad_pcb]
2017-10-09 + Antenna
    [SimpleJoyRx.kicad_pcb, SimpleJoyRx.sch]
2017-10-09 RX PCB seems done
    [SimpleJoyRx.dsn, SimpleJoyRx.kicad_pcb, SimpleJoyRx.sch]
2017-10-09 TX layout started
    [Display.DXF, SimpleJoyRx.kicad_pcb, SimpleJoyRx.sch, SimpleJoyTx.kicad_pcb, SimpleJoyTx.sch, TX.dwg, Tx.dxf]
2017-10-11 + Layout + antenna
    [SimpleJoyTx.kicad_pcb, SimpleJoyTx.sch]
2017-10-11 + SimpleJoy TX * Leg 63 bug fixed
    [SimpleJoyRx.dsn, SimpleJoyRx.kicad_pcb, SimpleJoyTx.dsn, SimpleJoyTx.kicad_pcb, SimpleJoyTx.sch]
2017-10-11 TX: USB and switch moved to edges. Sent to production.
    [SimpleJoyRx.kicad_pcb, SimpleJoyTx.dsn, SimpleJoyTx.kicad_pcb]
2017-10-26 + LEDs
2017-10-26 + Radio + PWM + Servo
2017-10-26 + Antennas matched
    [SimpleJoyRx.sch, SimpleJoyTx.sch]
2017-10-27 + TX firmware, LEDs work
2017-10-31 + ADC & calibration
2017-10-31 + Btns in pkt + Sign corrected
    [buttons.h, main.cpp]
2017-10-31 Something wrong with Lcd.GotoXY
    [lcd5110.cpp, lcd5110.h, main.cpp]
2017-11-02 + Joysticks X * Switch to 48MHz
2017-11-02 + Show battery
2017-11-03 + Srv + DC Motors
2017-11-03 Motors off on link down for 5400 ms
2017-11-04 * LCD do not inverts on start
    [lcd5110.cpp]
2017-11-05 + Logo display * Draw image invert bit order
    [interface.h, lcd5110.cpp, main.cpp]
2017-12-04 + RX v2
    [SimpleJoyRx.dsn, SimpleJoyRx.kicad_pcb, SimpleJoyRx.sch, SimpleJoyRx01BOM.xlsx, SimpleJoyTx.sch, SimpleJoyTxBOM.xlsx]
2018-04-27 * rPkt format changed * Rx v3 done Seems working
    [SimpleJoyRx-2018-01-31-15-33-24.sch, SimpleJoyRx-2018-02-06-14-59-20.sch, SimpleJoyRx.csv, SimpleJoyRx.dsn, SimpleJoyRx.kicad_pcb, SimpleJoyRx.sch, SimpleJoyRx21BOM.xlsx, SimpleJoyTx.csv]
2018-07-11 Switch to Atollic
    [SimpleJoyRx.kicad_pcb]
2018-07-11 + Mode switching
2018-07-13 + LED RGB
2018-07-13 Switch LED to hsv + flickering and color
2018-07-14 Switch to timer-driven LED
    [SimpleJoyTx.kicad_pcb]
2022-06-04 Old data
    [Display.DXF, SimpleJoyRx.csv, SimpleJoyRx.dsn, SimpleJoyRx.kicad_pcb, SimpleJoyRx.sch, SimpleJoyTx-2018-02-06-14-25-35.sch, SimpleJoyTx.csv, SimpleJoyTx.dsn]
