Kreyl/SimpleJoy/(notices)

Notices in the files:
SimpleJoyTx_fw/os/stm32f072/chcore_v6m.h:
ChibiOS is free software; you can redistribute it and/or modify
it under the terms of the GNU General Public License as published by
the Free Software Foundation; either version 3 of the License, or
(at your option) any later version.
